yaojiwww/tickboard/hardware/SCH_Schematic_2026-10-20.pdf

A | A
GND | GND GND EH ¹⁶ EH ¹⁵ EH 14 | EH 13

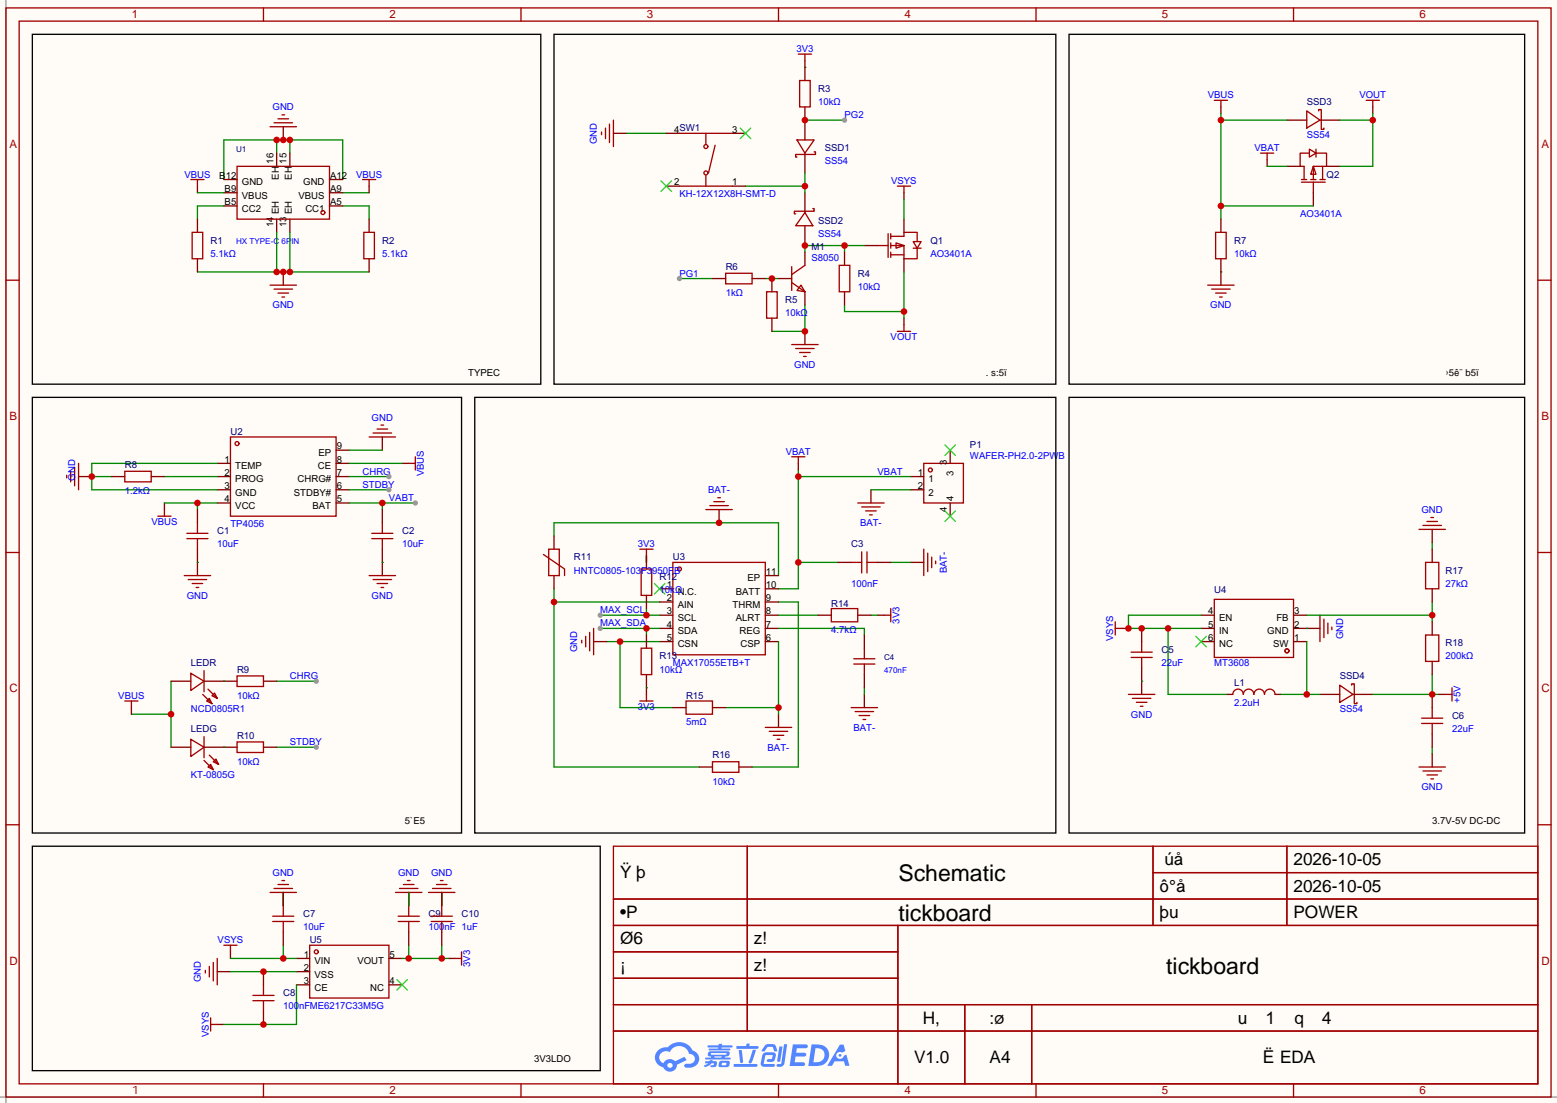
[picture p1: page 1]

Ÿþ | Schematic | úå | 2026-10-05

•P | tickboard | þu | POWER
Ø6 | z! | tickboard
¡ | z!

V1.0 | A4 | Ë EDA

11

22

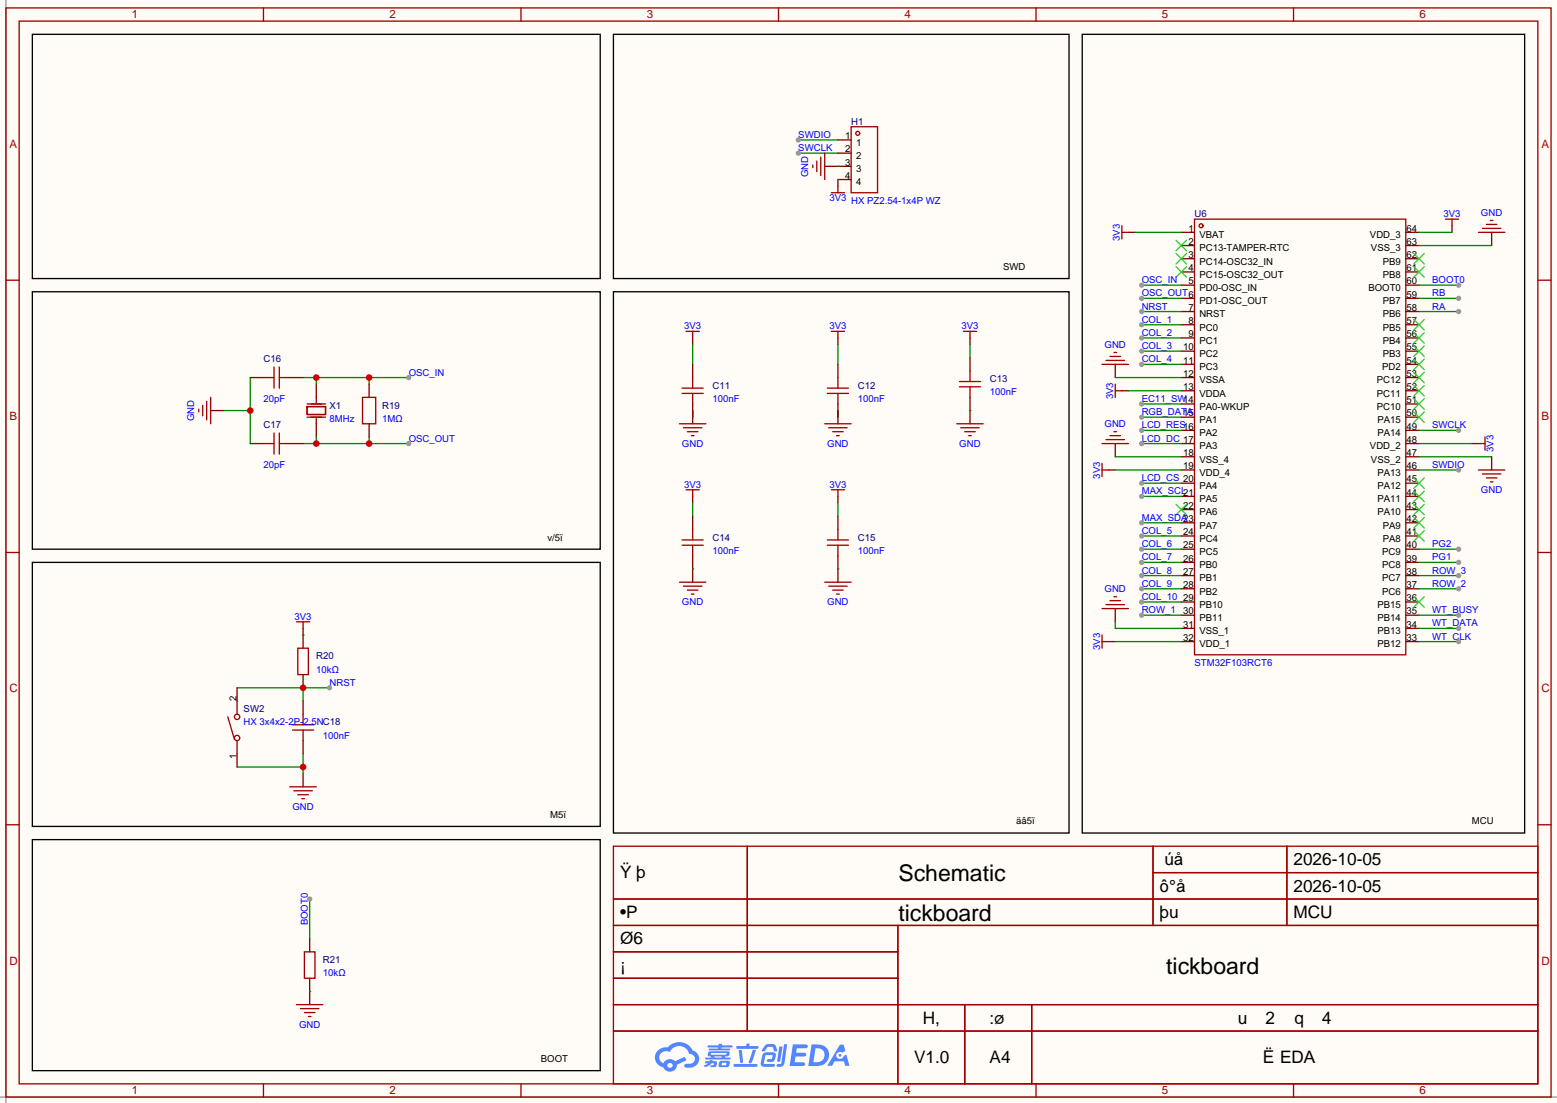
[picture p2: page 2]

Ÿþ | Schematic | úå | 2026-10-05
•P | tickboard | þu | MCU
Ø6 | | tickboard
¡

A | A

### GND

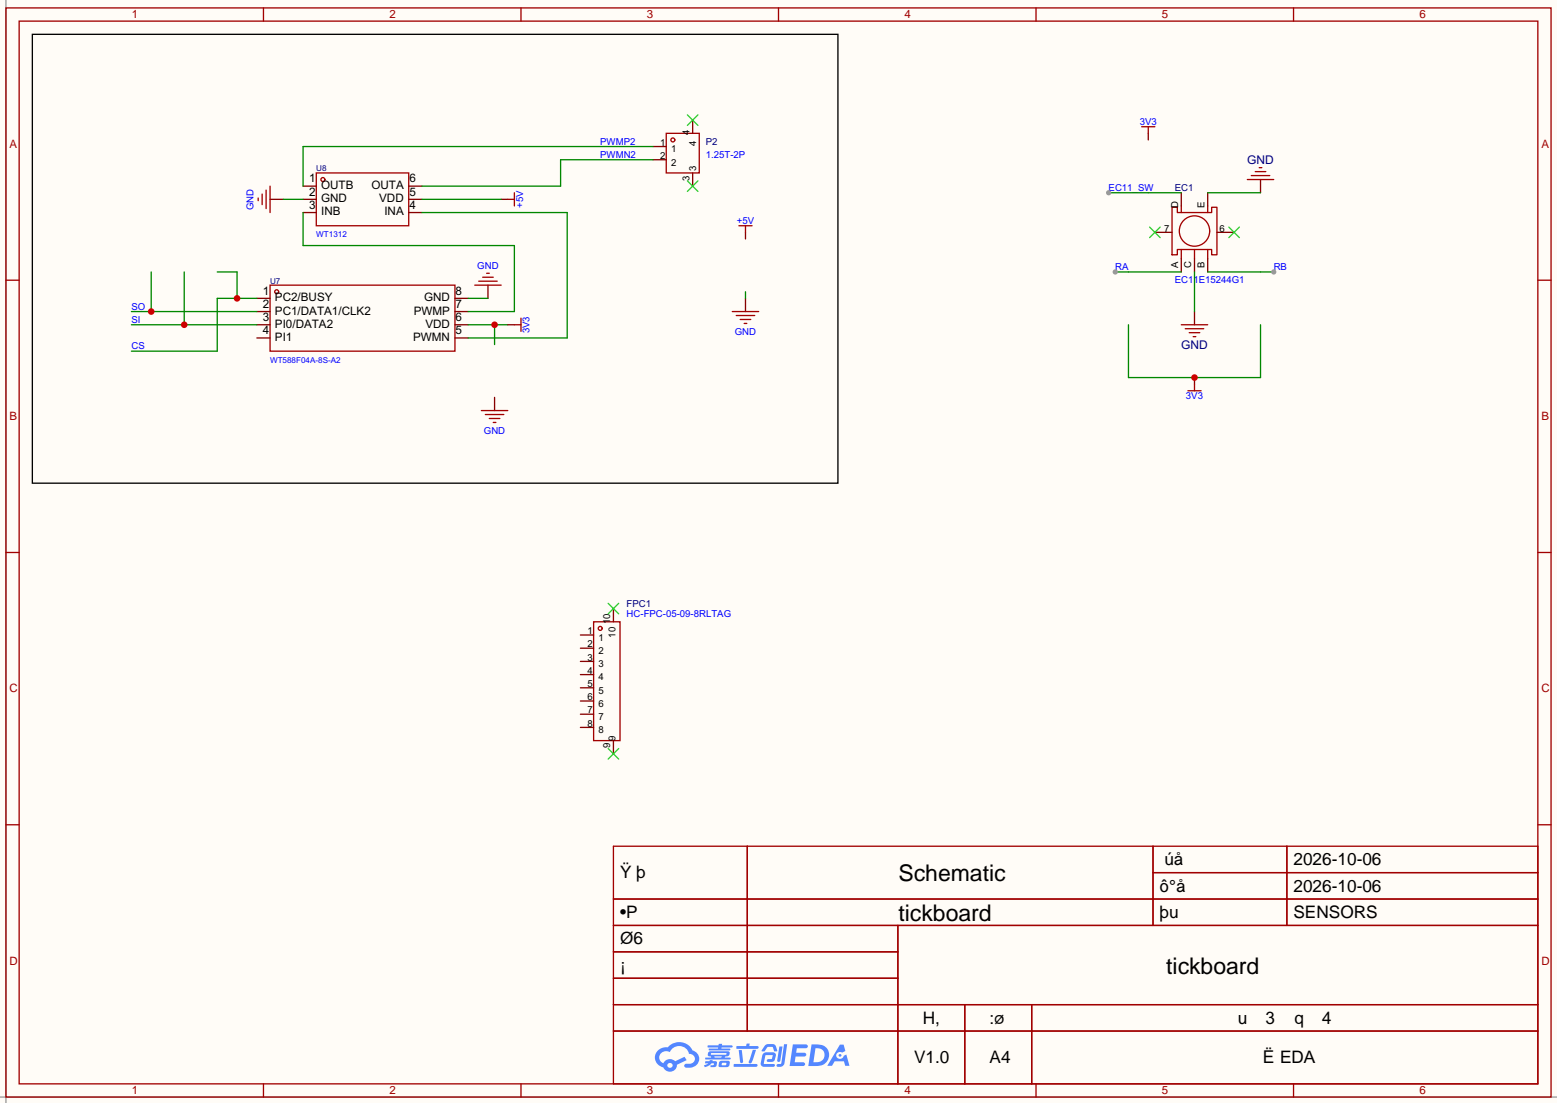
[picture p3: page 3]

Ÿþ | Schematic | úå | 2026-10-06

•P | tickboard | þu | SENSORS
Ø6 | | tickboard
¡

A | A

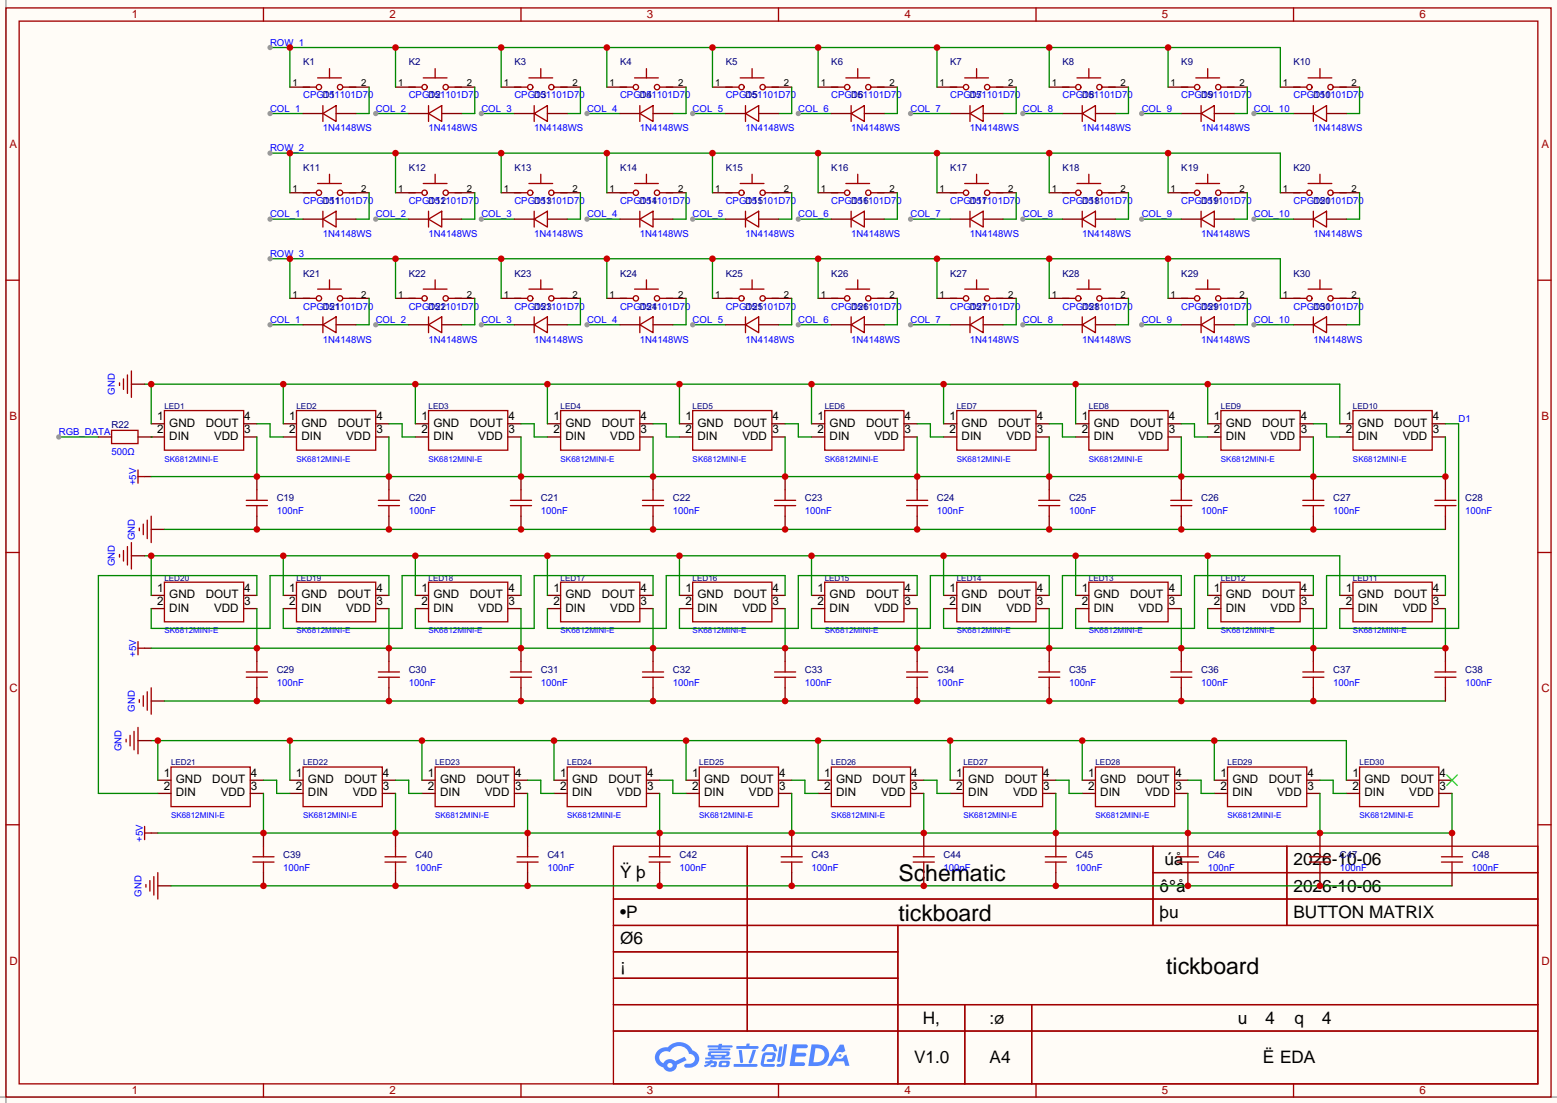
[picture p4: page 4]

•P | tickboard | þu | BUTTON MATRIX
Ø6 | | tickboard
¡
