yaojiwww/tickboard/hardware/SCH_Schematic_1-电源_2026-09-14.pdf

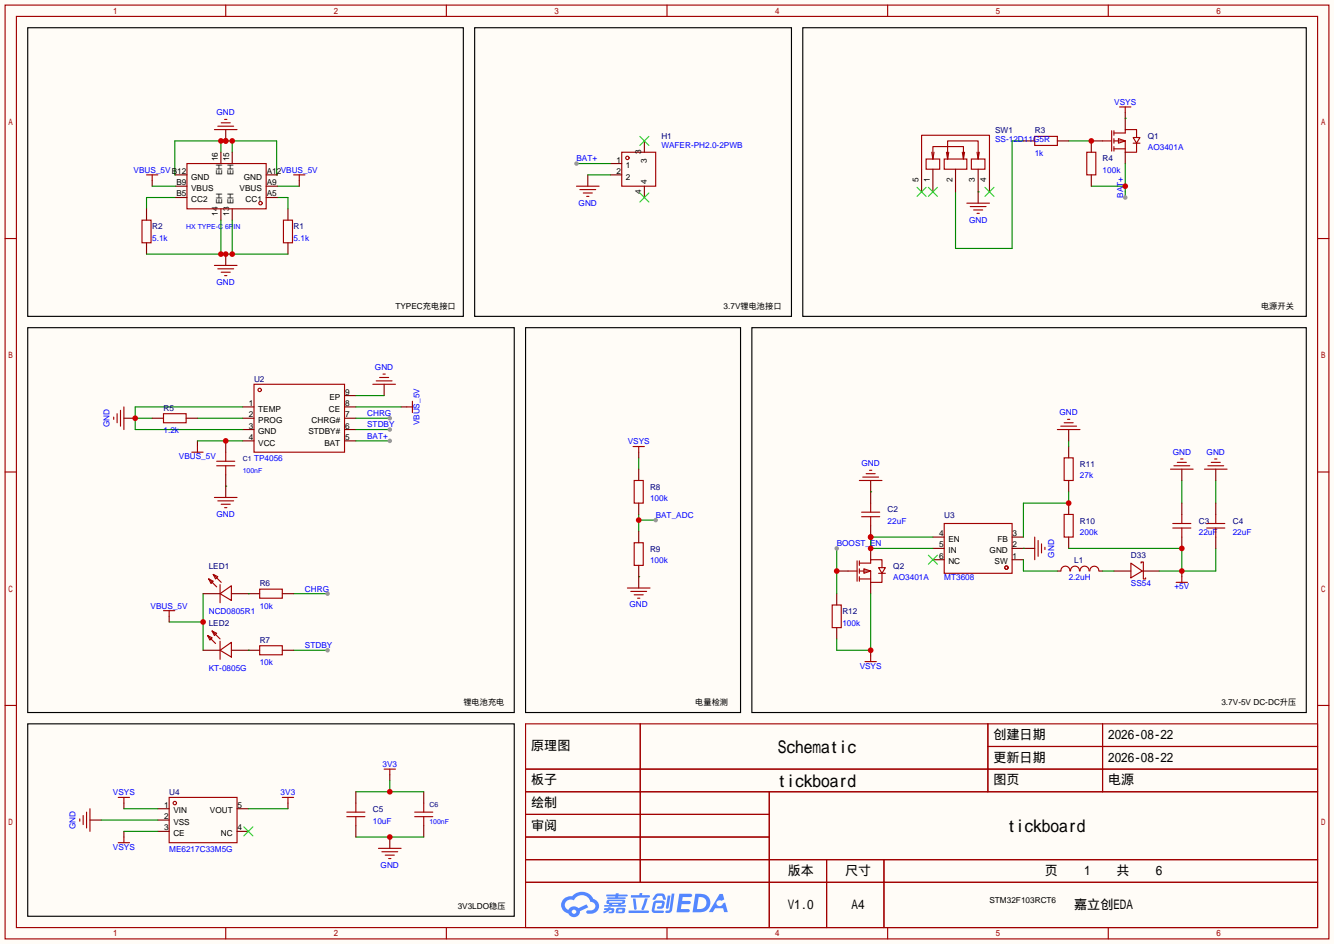
[picture p5: page 1]

原理图 | Schematic | 创建日期 | 2026-08-22

更新日期 | 2026-08-22

板子 | tickboard | 图页 | 电源
绘制 | | tickboard
审阅

V1.0 | A4 | STM32F103RCT6 嘉立创EDA
