yaojiwww/tickboard/hardware/SCH_Schematic_2-主控_2026-09-14.pdf

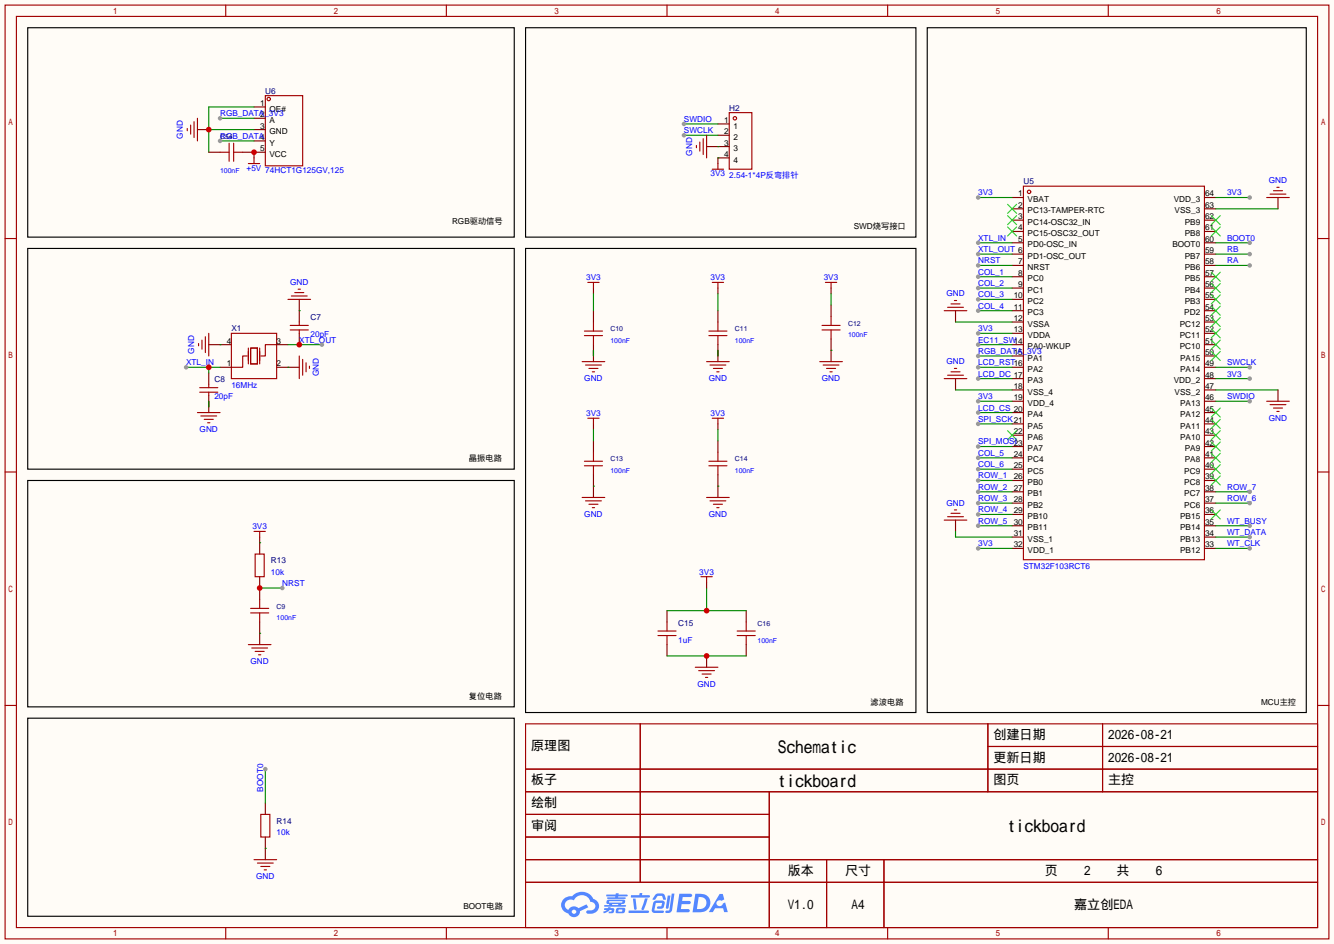
[picture p6: page 1]

原理图 | Schematic | 创建日期 | 2026-08-21

更新日期 | 2026-08-21

板子 | tickboard | 图页 | 主控
绘制 | | tickboard
审阅

V1.0 | A4 | 嘉立创EDA
