yaojiwww/tickboard/hardware/SCH_Schematic_3-按键矩阵_2026-09-14.pdf

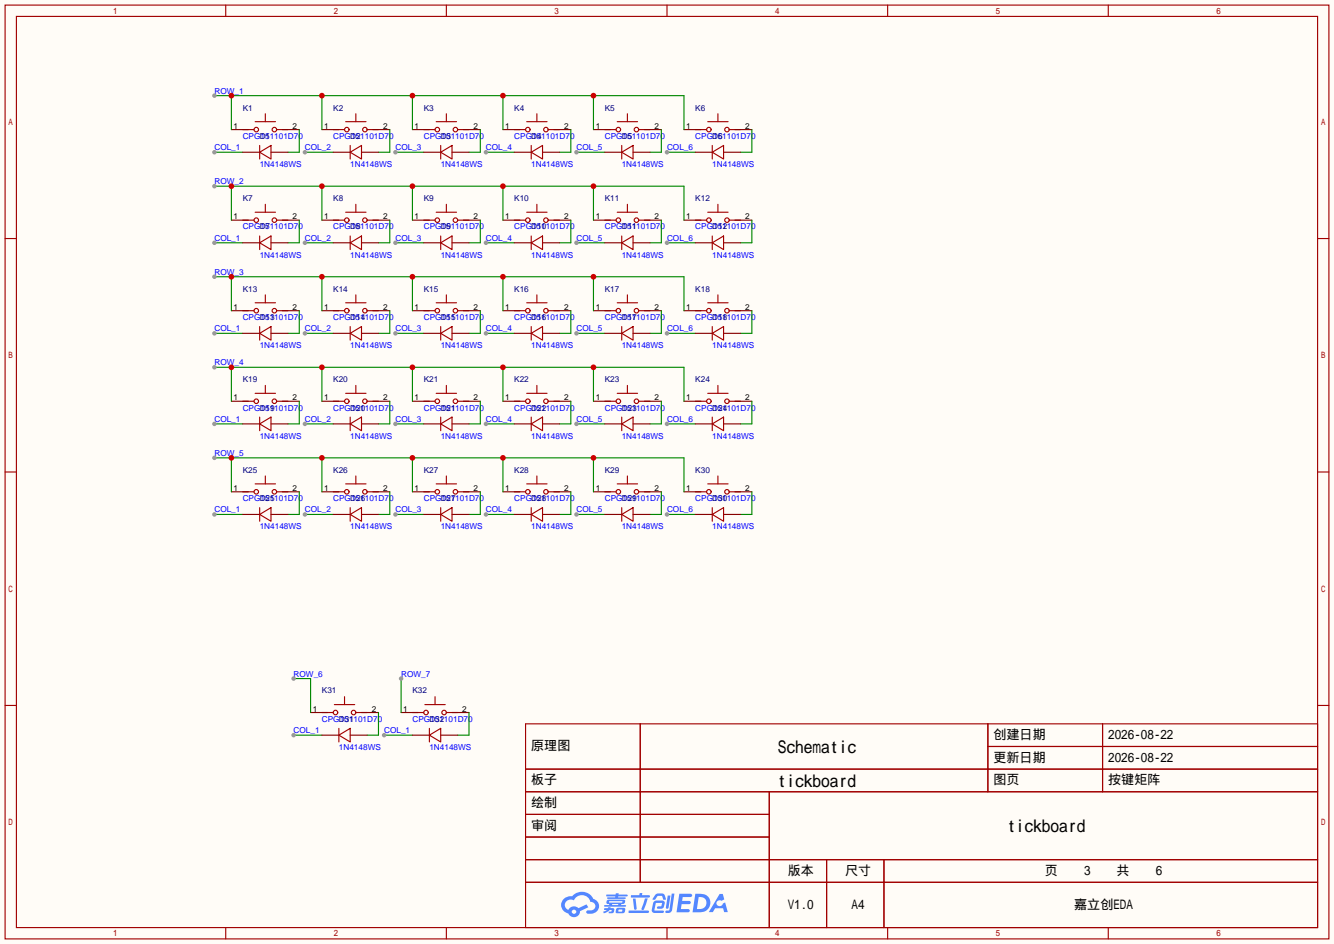
[picture p7: page 1]

原理图 | Schematic | 创建日期 | 2026-08-22

更新日期 | 2026-08-22

板子 | tickboard | 图页 | 按键矩阵
绘制 | | tickboard
审阅

V1.0 | A4 | 嘉立创EDA
