yaojiwww/tickboard/hardware/SCH_Schematic_4-RGB灯效_2026-09-14.pdf

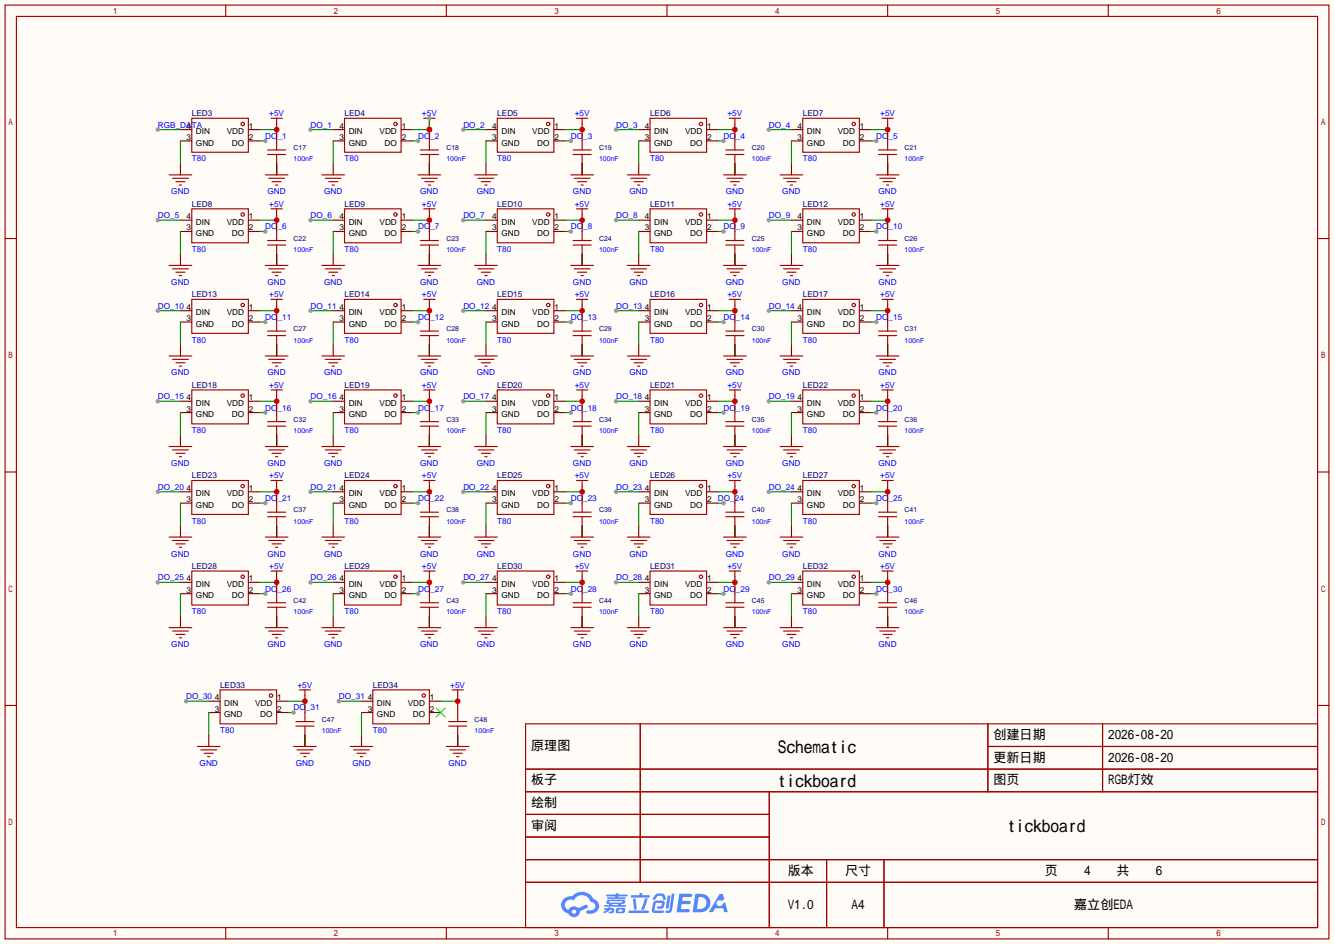
[picture p8: page 1]

原理图 | Schematic | 创建日期 | 2026-08-20

更新日期 | 2026-08-20

板子 | tickboard | 图页 | RGB灯效
绘制 | | tickboard
审阅

V1.0 | A4 | 嘉立创EDA
