yaojiwww/tickboard/hardware/SCH_Schematic_5-音频_2026-09-14.pdf

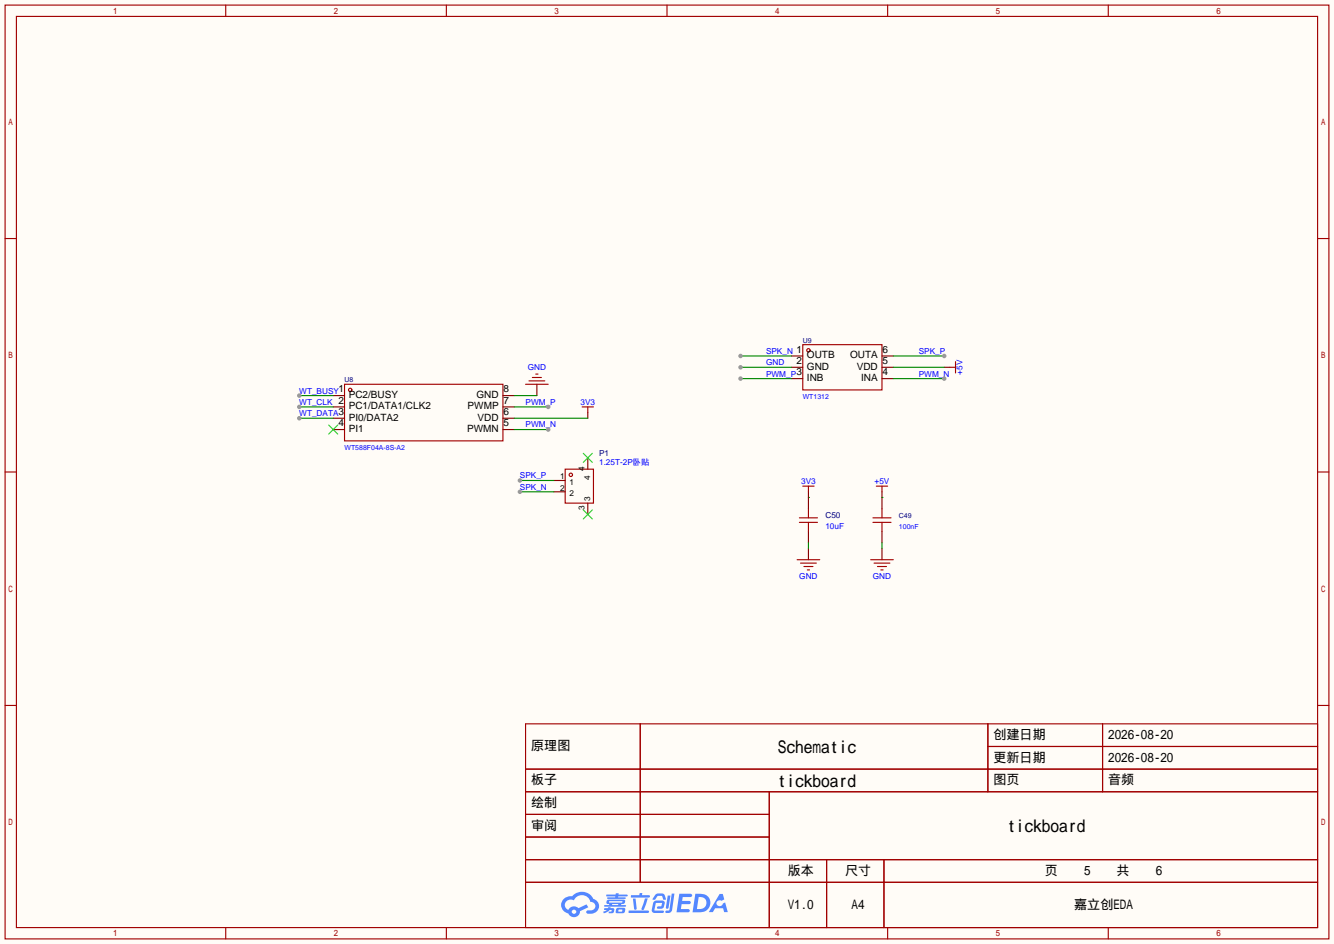
[picture p9: page 1]

原理图 | Schematic | 创建日期 | 2026-08-20

更新日期 | 2026-08-20

板子 | tickboard | 图页 | 音频
绘制 | | tickboard
审阅

V1.0 | A4 | 嘉立创EDA
