yaojiwww/tickboard/software/Core/Src/main.c

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
/* Includes ------------------------------------------------------------------*/
#include "main.h"

/* USER CODE BEGIN Includes */
#include "app.h"
/* USER CODE END Includes */


/* USER CODE BEGIN PV */
uint8_t g_clock_hse_ok = 0U;
/* USER CODE END PV */

void SystemClock_Config(void);
/**
  * @brief  The application entry point.
  * @retval int
  */
int main(void)
{

  /* USER CODE BEGIN 1 */
  /*
   * 尽早锁存电源：此时 SystemClock_Config 还没执行，
   * 直接操作寄存器把 PG1(PC8) 拉高，避免按键松开后掉电。
   */
  RCC->APB2ENR |= RCC_APB2ENR_IOPCEN;
  (void)RCC->APB2ENR;
  GPIOC->BSRR = GPIO_PIN_8;                                   /* ODR8 = 1 */
  GPIOC->CRH  = (GPIOC->CRH & ~(0xFU << 0)) | (0x2U << 0);    /* PC8: 2MHz 推挽输出 */
  /* USER CODE END 1 */

  /* MCU Configuration--------------------------------------------------------*/

  /* Reset of all peripherals, Initializes the Flash interface and the Systick. */
  HAL_Init();

  /* Configure the system clock */
  SystemClock_Config();

  /* Initialize all configured peripherals */
  /* USER CODE BEGIN 2 */
  APP_Init();
  /* USER CODE END 2 */

  /* Infinite loop */
  /* USER CODE BEGIN WHILE */
  while (1)
  {
    /* USER CODE END WHILE */

    /* USER CODE BEGIN 3 */
    APP_Run();
  }
  /* USER CODE END 3 */
}

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
