yaojiwww/tickboard/software/User/Inc/pic.h

#ifndef _PIC_H_
#define _PIC_H_

/************************************************************************************
                                LCD图片取模教程                                      
    输出数据类型:C语言数组
    扫描方式:水平扫描
    输出灰度:16位真彩色
    最大宽度高度:按照显示的宽高进行设置该软件仅可等比例缩小
    勾选高位在前，区域无需勾选
************************************************************************************/


const unsigned char gImage_1[11760] = { /* 0X10,0X10,0X00,0X69,0X00,0X38,0X01,0X1B, */
0XFF,0XFF,0XFF,0XFF,0XFF,0XFF,0XFF,0XFF,0XFF,0XFF,0XFF,0XFF,0XFF,0XFF,0XFF,0XFF,
0XFF,0XFF,0XFF,0XFF,0XFF,0XFF,0XFF,0XFF,0XFF,0XFF,0XFF,0XFF,0XFF,0XFF,0XFF,0XFF,
0XFF,0XFF,0XFF,0XFF,0XFF,0XFF,0XFF,0XFF,0XFF,0XFF,0XFF,0XFF,0XFF,0XFF,0XFF,0XFF,
0XFF,0XFF,0XFF,0XFF,0XFF,0XFF,0XFF,0XFF,0XFF,0XFF,0XFF,0XFF,0XFF,0XFF,0XEF,0XFF,
0X96,0XBF,0X13,0XD7,0X0C,0X7A,0X04,0X7A,0X04,0X7A,0X04,0X59,0X04,0X7A,0X04,0X7A,
0X04,0X3B,0X04,0X3B,0X04,0X3A,0X04,0X3A,0X04,0X5A,0X04,0X5A,0X04,0X5A,0X04,0X5A,
0X04,0X3A,0X04,0X3A,0X04,0X3A,0X04,0X3A,0X04,0X3A,0X04,0X3A,0X04,0X3A,0X04,0X19,
0X04,0X19,0X04,0X19,0X03,0XD8,0X34,0X37,0XEF,0XFF,0XFF,0XFF,0XFF,0XFF,0XE7,0XFF,
0X12,0XF4,0X0B,0XD9,0X03,0XF8,0X03,0XF8,0X03,0XD9,0X03,0XB9,0X0B,0XB9,0X13,0X14,
0X9E,0X3C,0XF7,0XFF,0XFF,0XFF,0XFF,0XFF,0XFF,0XDF,0XFF,0XDF,0XFF,0XFF,0XFF,0XFF,
0XFF,0XFF,0XFF,0XFF,0XFF,0XFF,0XFF,0XFF,0XFF,0XFF,0XFF,0XFF,0XFF,0XFF,0XFF,0XFF,
0XFF,0XFF,0XFF,0XFF,0XFF,0XFF,0XFF,0XFF,0XFF,0XFF,0XFF,0XFF,0XFF,0XFF,0XFF,0XFF,
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
0X8C,0XF7,0X42,0XD2,0X3A,0X92,0X42,0XB0,0XAD,0XB9,0XFF,0XFF,0XFF,0XFF,0XF7,0XFF,
0XEF,0XDF,0X42,0XF2,0X2A,0X50,0X63,0X72,0X8C,0X95,0XF7,0XFF,0XD6,0XFF,0X21,0XCD,
0X42,0XD0,0X84,0XB4,0XF7,0XFF,0X7C,0X56,0X42,0XB2,0X32,0X31,0X3A,0X50,0XF7,0XFF,
0X63,0X50,0X3A,0X2D,0X63,0XB2,0XF7,0XFF,0XFF,0XFF,0XAD,0XBE,0X42,0X31,0XEF,0X9F,
};
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
