yaojiwww/tickboard/software/User/Src/board.c

#include "board.h"

void Board_Init(void)
{
    __HAL_RCC_GPIOA_CLK_ENABLE();
    __HAL_RCC_GPIOB_CLK_ENABLE();
    __HAL_RCC_GPIOC_CLK_ENABLE();
    __HAL_RCC_AFIO_CLK_ENABLE();

    /* 使能 DWT 周期计数器，WS2812 位时序与微秒延时依赖它 */
    CoreDebug->DEMCR |= CoreDebug_DEMCR_TRCENA_Msk;
    DWT->CYCCNT = 0U;
    DWT->CTRL |= DWT_CTRL_CYCCNTENA_Msk;
}

void Board_DelayUs(uint32_t us)
{
    uint32_t cycles = us * (SystemCoreClock / 1000000U);
    uint32_t start = DWT->CYCCNT;

    while ((DWT->CYCCNT - start) < cycles)
    {
    }
}
