yaojiwww/tickboard/(commit log)

2026-08-18 新增文件夹
2026-09-14 导入厂商 LCD 驱动例程
2026-09-14 修改项目工程结构
2026-09-14 上传sch原理图
2026-10-22 可开机+按下反转
